kdumontnu/icezum/src-kicad/Power-supply.kicad_sch

## KiCad design src-kicad/Power-supply.kicad_sch (2023-02-05)

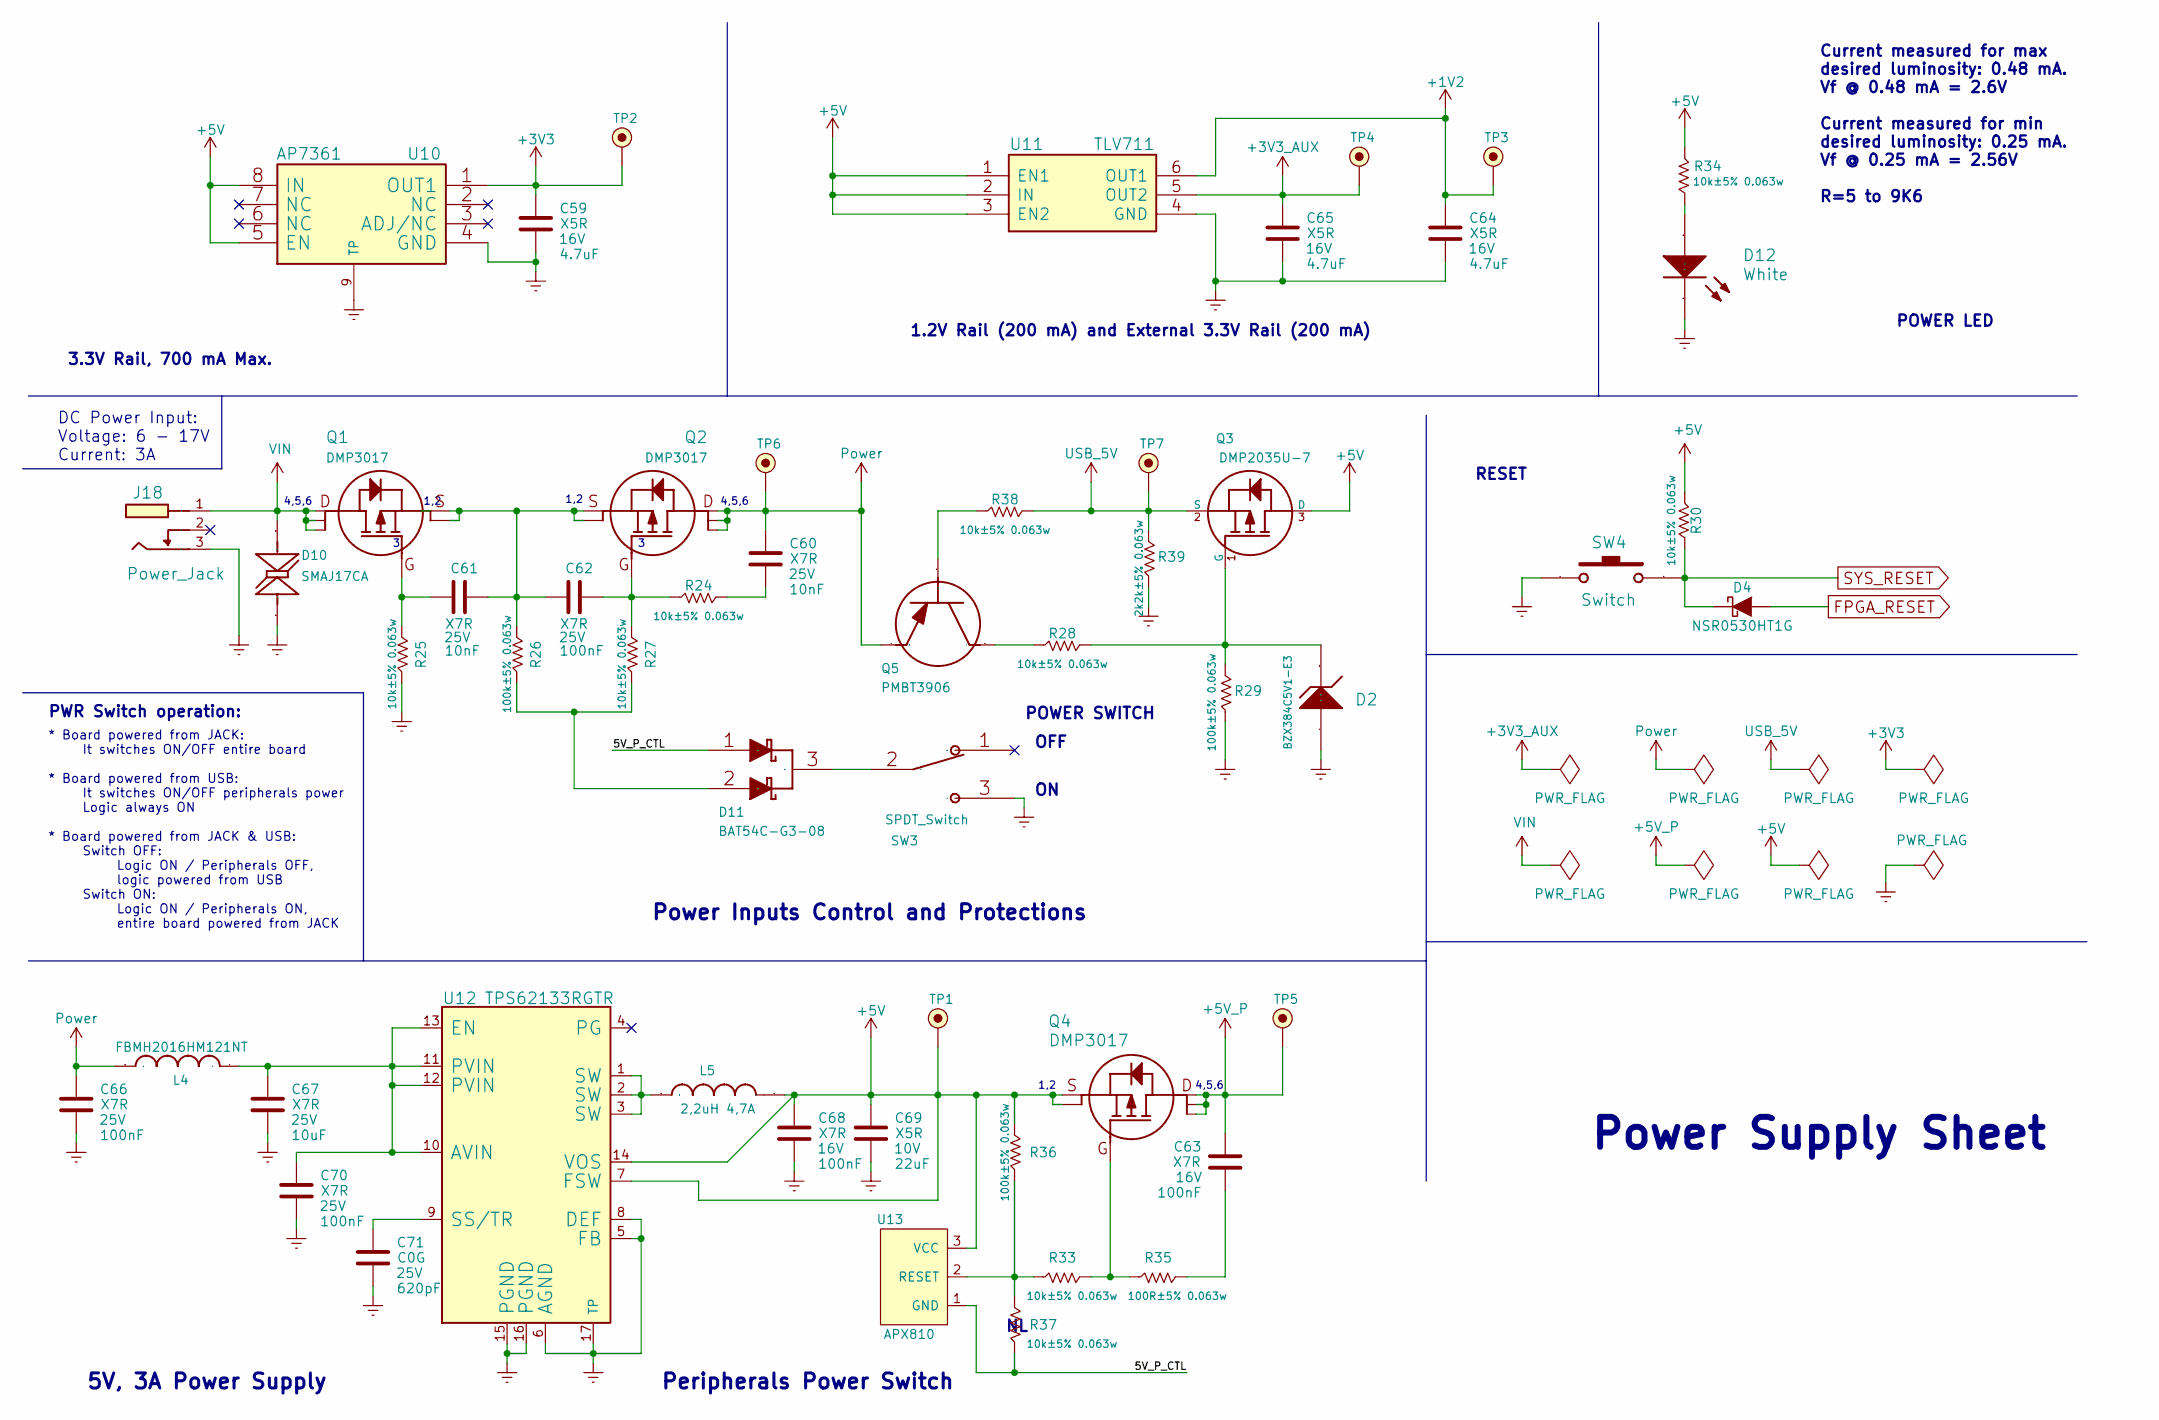
[picture p1: schematic Power-supply.kicad_sch]

Parts:
C59, C64, C65: 4.7uF; C_0603; Voltage 16V
C60, C61: 10nF; C_0603; Voltage 25V
C62, C66, C70: 100nF; C_0603; Voltage 25V
C63, C68: 100nF; C_0402; Voltage 16V
C67: 10uF; C_1206; Voltage 25V
C69: 22uF; C_1206; Voltage 10V
C71: 620pF; C_0603; Voltage 25V
D2: BZX384C5V1-E3; SOD-323
D4: NSR0530HT1G; SOD-323
D10: SMAJ17CA; DO-214AC
D11: BAT54C-G3-08; SOT-23
D12: White; LED_0603
J18: Power_Jack; JACK_2.1
L4: Ferrite_Bead; L_0806
L5: 2,2uH 4,7A; L_4040
Q1, Q2, Q4: DMP3017; DFN-2523-6
Q3: DMP2035U-7; SOT-23
Q5: PMBT3906; SOT-23
R24, R25, R27, R28, R30, R33, R34, R37, R38: 10k±5% 0.063w; R_0402
R26, R29, R36: 100k±5% 0.063w; R_0402
R35: 100R±5% 0.063w; R_0402
R39: 2k2k±5% 0.063w; R_0402
SW3: SPDT_Switch; slide-sw-spdt-right-angle
SW4: Switch; SW_vert_tht_7.5x6x6.5
TP1, TP2, TP3, TP4, TP5, TP6, TP7: TestPoint_Small; Via_Test_point
U10: AP7361; DFN-3030-8_VIATP
U11: TLV711; WSON-6
U12: TPS62133RGTR; QFN16_VIATP
U13: APX810; SOT-23

Connections:
5V_P_CTL: D11.1 (A1), R37.1, U13.1 (GND)
+1V2: C64.1, TP3.1, U11.6 (OUT1)
+3V3: C59.1, TP2.1, U10.1 (OUT1)
+3V3_AUX: C65.1, TP4.1, U11.5 (OUT2)
+5V: C68.1, C69.1, L5.2, Q3.3 (D), Q4.1 (S), Q4.2 (S), R30.1, R34.1, R36.2, TP1.1, U10.5 (EN), U10.8 (IN), U11.1 (EN1), U11.2 (IN), U11.3 (EN2), U12.7 (FSW), U12.14 (VOS), U13.3 (VCC)
+5V_P: C63.1, Q4.4 (D), Q4.5 (D), Q4.6 (D), TP5.1
FPGA_RESET: D4.2 (A)
GNDREF: C59.2, C64.2, C65.2, C66.2, C67.2, C68.2, C69.2, C70.2, C71.2, D2.2 (A), D10.A, D12.K, J18.3, R25.1, R29.1, R39.1, SW3.3, SW4.2, U10.4 (GND), U10.9 (TP), U11.4 (GND), U12.5 (FB), U12.6 (AGND), U12.8 (DEF), U12.15 (PGND), U12.16 (PGND), U12.17 (TP)
unnamed: C60.2, R24.2
unnamed: C61.1, C62.2, Q1.1 (S), Q1.2 (S), Q2.1 (S), Q2.2 (S), R26.2
unnamed: C61.2, Q1.3 (G), R25.2
unnamed: C62.1, Q2.3 (G), R24.1, R27.2
unnamed: C63.2, R35.2
unnamed: C67.1, C70.1, L4.2, U12.10 (AVIN), U12.11 (PVIN), U12.12 (PVIN), U12.13 (EN)
unnamed: C71.1, U12.9 (SS/TR)
unnamed: D2.1 (K), Q3.1 (G), R28.2, R29.2
unnamed: D11.2 (A2), R26.1, R27.1
unnamed: D11.3 (K), SW3.2
unnamed: D12.A, R34.2
unnamed: L5.1, U12.1 (SW), U12.2 (SW), U12.3 (SW)
unnamed: Q4.3 (G), R33.2, R35.1
unnamed: Q5.1 (B), R38.1
unnamed: Q5.3 (C), R28.1
unnamed: R33.1, R36.1, R37.2, U13.2 (RESET)
Power: C60.1, C66.1, L4.1, Q2.4 (D), Q2.5 (D), Q2.6 (D), Q5.2 (E), TP6.1
SYS_RESET: D4.1 (K), R30.2, SW4.1
USB_5V: Q3.2 (S), R38.2, R39.2, TP7.1
VIN: D10.K, J18.1, Q1.4 (D), Q1.5 (D), Q1.6 (D)

Notes on the sheet:
4,5,6
1,2
PWR Switch operation:
* Board powered from JACK: It switches ON/OFF entire board * Board powered from USB: It switches ON/OFF peripherals power Logic always ON * Board powered from JACK & USB: Switch OFF: Logic ON / Peripherals OFF, logic powered from USB Switch ON: Logic ON / Peripherals ON, entire board powered from J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
5V, 3A Power Supply
Peripherals Power Switch
1.2V Rail (200 mA) and External 3.3V Rail (200 mA)
3.3V Rail, 700 mA Max.
DC Power Input: Voltage: 6 - 17V Current: 3A
Current measured for max desired luminosity: 0.48 mA. Vf @ 0.48 mA = 2.6V Current measured for min desired luminosity: 0.25 mA. Vf @ 0.25 mA = 2.56V R=5 to 9K6
Power Inputs Control and Protections
RESET
POWER SWITCH
POWER LED
Power Supply Sheet
OFF
