kdumontnu/icezum/src-kicad/peripherals.kicad_sch

## KiCad design src-kicad/peripherals.kicad_sch (2023-02-05)

Schematic: peripherals.kicad_sch

Parts:
C34, C35, C45, C46: 100nF; C_0402; Voltage 16V
C41: 4.7uF; C_0603; Voltage 16V
DOC3: icezum-headers-doc; None
DOC4, DOC5: switch_DOC; None
J15, J16, J17: 1x4_male_pin_Header_2.54mm; 1x04-pin-header-2.54mm
JP1: Jumper_3pin; 1x03-pin-header-2.54mm
JPM1: Jumper_1x2_Mech; None
LD0, LD1, LD2, LD3, LD4, LD5, LD6, LD7: Green; LED_0603
R17, R18, R40, R41, R42, R43, R44, R45: 2k2±5% 0.063w; R_0402
R19: 10R±5% 0.063w; R_0402
R20, R21: 10k±5% 0.063w; R_0402
R31, R32: 10k±5% 0.0625w; R_0402
SW1, SW2: (no value)
U7: ADS7924; QFN16_VIATP
doc9: 3x4_pin_male_header_DOC; None
doc10: 1x3_pin_male_header_v_DOC; None

Notes on the sheet:
1x4 male pin header 2.54mm
REF
VCC
AREF
User LEDS
Analog inputs
User Switches
4-Channel I2C ADC
Peripherals SHEET
ICEZUM
GND
