kdumontnu/icezum/src-kicad/usb-communications.kicad_sch

## KiCad design src-kicad/usb-communications.kicad_sch (2023-02-05)

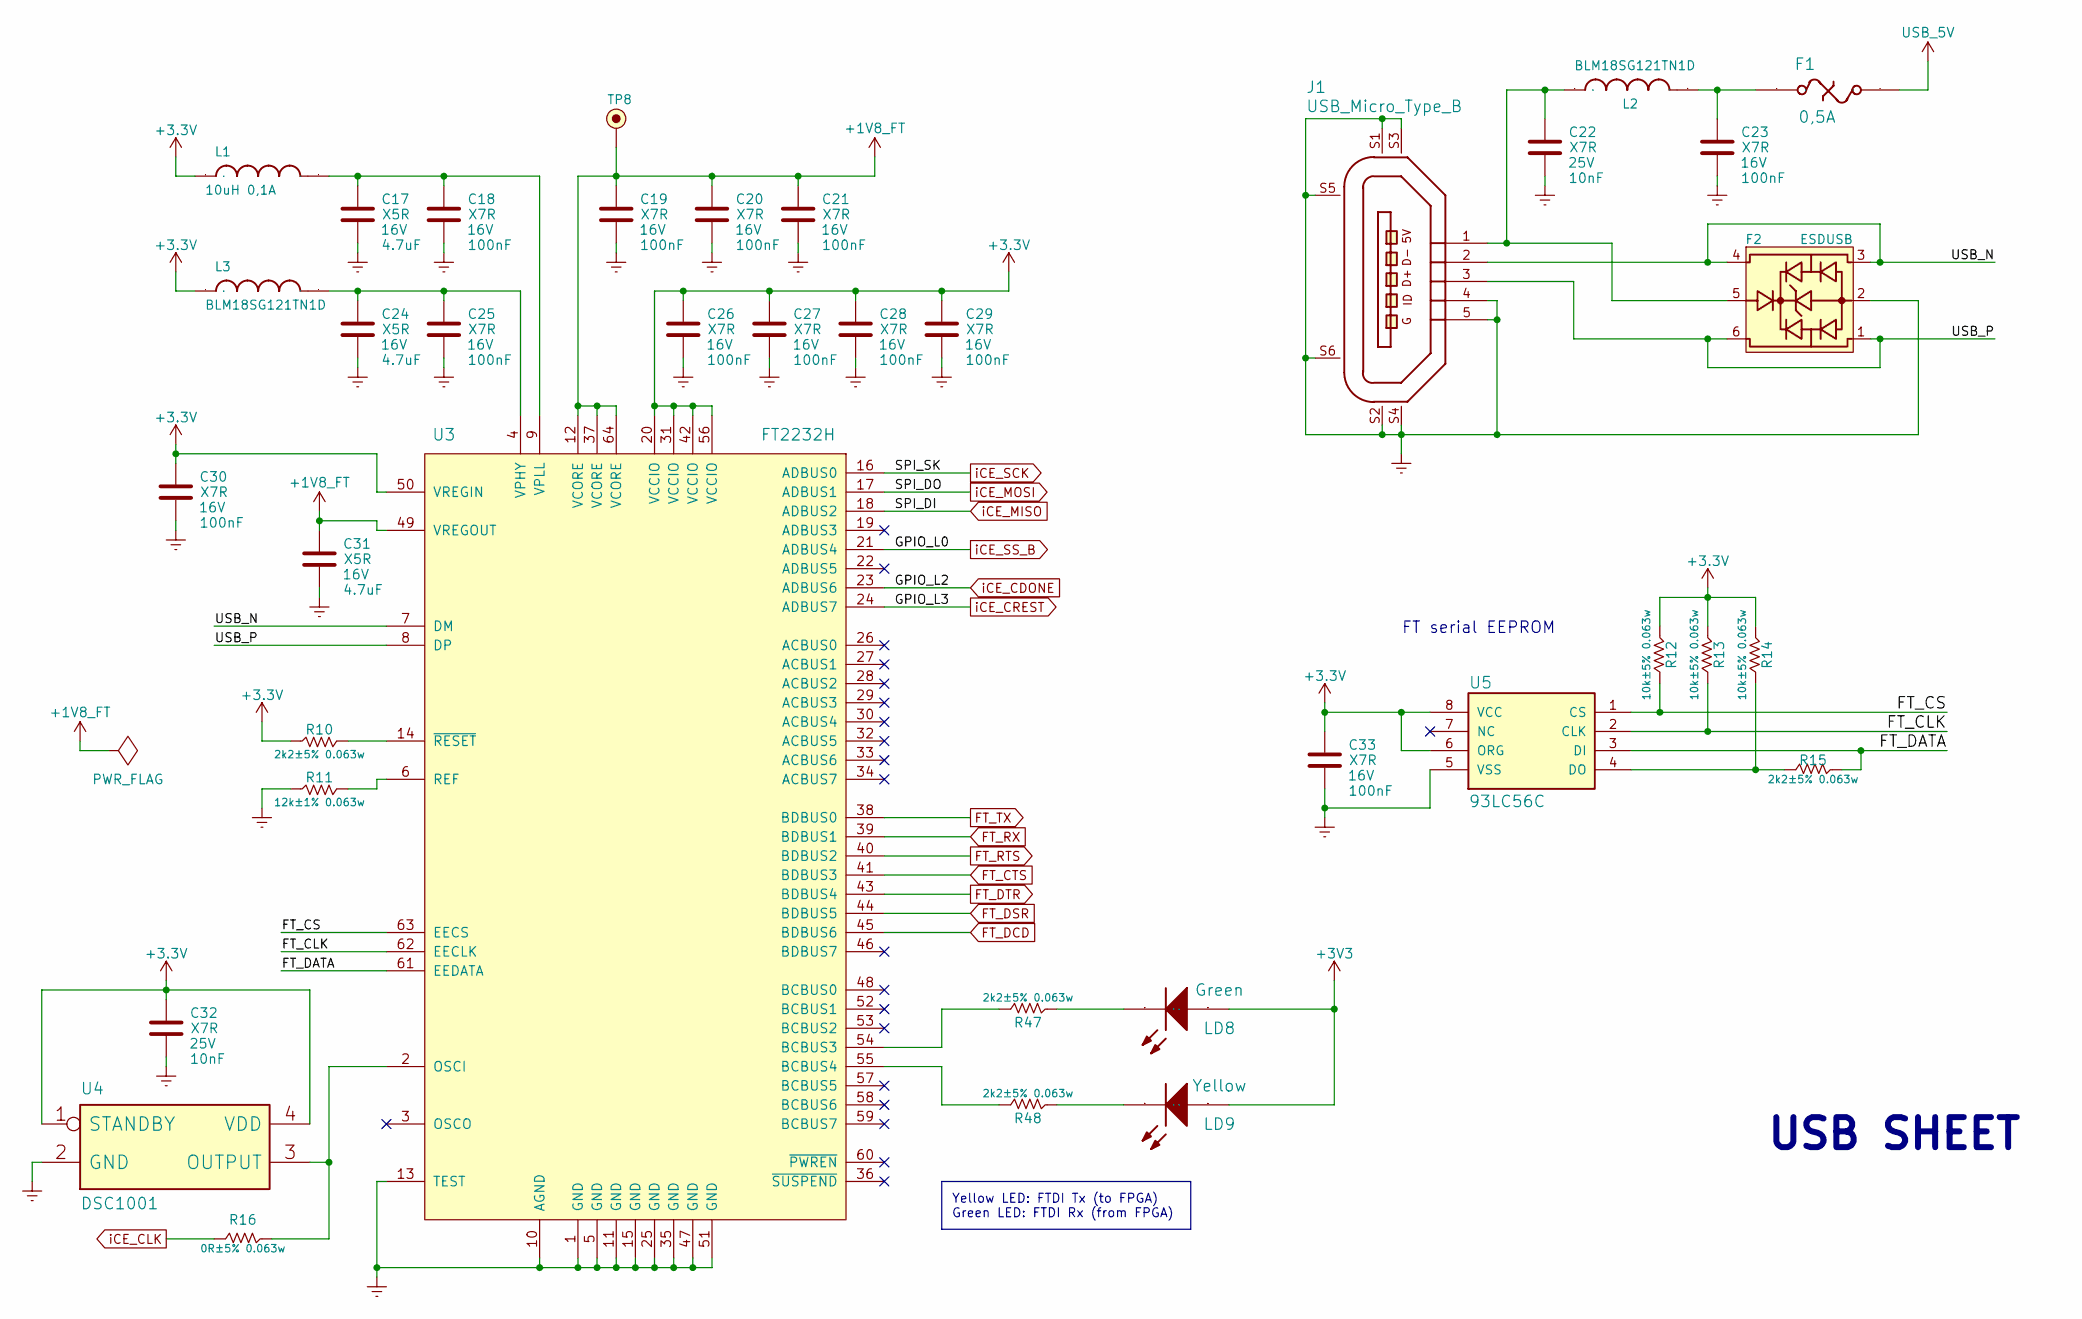
[picture p4: schematic usb-communications.kicad_sch]

Parts:
C17, C24, C31: 4.7uF; C_0603; Voltage 16V
C18, C19, C20, C21, C23, C25, C26, C27, C28, C29, C30, C33: 100nF; C_0402; Voltage 16V
C22, C32: 10nF; C_0603; Voltage 25V
F1: 0,5A; F_0805
F2: ESDUSB; SOT-563
J1: USB_Micro_Type_B; USB_Micro-B
L1: 10uH 0,1A; L_0805
L2, L3: BLM18SG121TN1D; L_0603
LD8: Green; LED_0603
LD9: Yellow; LED_0603
R10, R15, R47, R48: 2k2±5% 0.063w; R_0402
R11: 12k±1% 0.063w; R_0402
R12, R13, R14: 10k±5% 0.063w; R_0402
R16: 0R±5% 0.063w; R_0402
TP8: TestPoint_Small; Via_Test_point
U3: FT2232H; FTDI-QFN-64
U4: DSC1001; Xtal-3_2x2_5
U5: 93LC56C; MSOP-8_3x3mm_Pitch0.65mm

Connections:
+1V8_FT: C19.1, C20.1, C21.1, C31.1, TP8.1, U3.12 (VCORE), U3.37 (VCORE), U3.49 (VREGOUT), U3.64 (VCORE)
+3.3V: C26.1, C27.1, C28.1, C29.1, C30.1, C32.1, C33.1, L1.1, L3.1, R10.1, R12.1, R13.1, R14.1, U3.20 (VCCIO), U3.31 (VCCIO), U3.42 (VCCIO), U3.50 (VREGIN), U3.56 (VCCIO), U4.1 (STANDBY), U4.4 (VDD), U5.6 (ORG), U5.8 (VCC)
+3V3: LD8.A, LD9.A
FT_CLK: R13.2, U3.62 (EECLK), U5.2 (CLK)
FT_CS: R12.2, U3.63 (EECS), U5.1 (CS)
FT_CTS: U3.41 (BDBUS3)
FT_DATA: R15.1, U3.61 (EEDATA), U5.3 (DI)
FT_DCD: U3.45 (BDBUS6)
FT_DSR: U3.44 (BDBUS5)
FT_DTR: U3.43 (BDBUS4)
FT_RTS: U3.40 (BDBUS2)
FT_RX: U3.39 (BDBUS1)
FT_TX: U3.38 (BDBUS0)
GNDREF: C17.2, C18.2, C19.2, C20.2, C21.2, C22.2, C23.2, C24.2, C25.2, C26.2, C27.2, C28.2, C29.2, C30.2, C31.2, C32.2, C33.2, F2.2, J1.4, J1.5, J1.S1 (SHLD1), J1.S2 (SHLD2), J1.S3 (SHLD3), J1.S4 (SHLD4), J1.S5 (SHLD5), J1.S6 (SHLD6), R11.1, U3.1 (GND), U3.5 (GND), U3.10 (AGND), U3.11 (GND), U3.13 (TEST), U3.15 (GND), U3.25 (GND), U3.35 (GND), U3.47 (GND), U3.51 (GND), U4.2 (GND), U5.5 (VSS)
unnamed: C17.1, C18.1, L1.2, U3.9 (VPLL)
unnamed: C22.1, F2.5, J1.1, L2.1
unnamed: C23.1, F1.1, L2.2
unnamed: C24.1, C25.1, L3.2, U3.4 (VPHY)
unnamed: LD8.K, R47.1
unnamed: LD9.K, R48.1
unnamed: R10.2, U3.14 (~RESET)
unnamed: R11.2, U3.6 (REF)
unnamed: R14.2, R15.2, U5.4 (DO)
unnamed: R16.1, U3.2 (OSCI), U4.3 (OUTPUT)
unnamed: R47.2, U3.54 (BCBUS3)
unnamed: R48.2, U3.55 (BCBUS4)
USB_5V: F1.2
USB_N: F2.3, F2.4, J1.2, U3.7 (DM)
USB_P: F2.1, F2.6, J1.3, U3.8 (DP)
iCE_CDONE: U3.23 (ADBUS6)
iCE_CLK: R16.2
iCE_CREST: U3.24 (ADBUS7)
iCE_MISO: U3.18 (ADBUS2)
iCE_MOSI: U3.17 (ADBUS1)
iCE_SCK: U3.16 (ADBUS0)
iCE_SS_B: U3.21 (ADBUS4)

Notes on the sheet:
Yellow LED: FTDI Tx (to FPGA) Green LED: FTDI Rx (from FPGA)
USB SHEET
FT serial EEPROM
