kdumontnu/icezum/(commit log)

2023-02-05 Update file-names
    [Power-supply.kicad_sch, arduino-sockets.kicad_sch, block-diagram.kicad_sch, fpga.kicad_sch, icezum.kicad_sch, peripherals.kicad_sch, usb-communications.kicad_sch]
2023-02-05 Update to KiCAD 6.0
    [Power-supply.kicad_sch, arduino-sockets.kicad_sch, block-diagram.kicad_sch, fpga.kicad_sch, icezum.kicad_sch, peripherals.kicad_sch, usb-communications.kicad_sch]
