kdumontnu/icezum/(notices)

Notices in the files:
src-kicad/block-diagram.kicad_sch:
License: Creative commons Attribution ShareAlike
